brunofbloq/testrepo/mallow_adapt_v1.3.kicad_pcb

## KiCad design mallow_adapt_v1.3.kicad_pcb (2025-02-27)

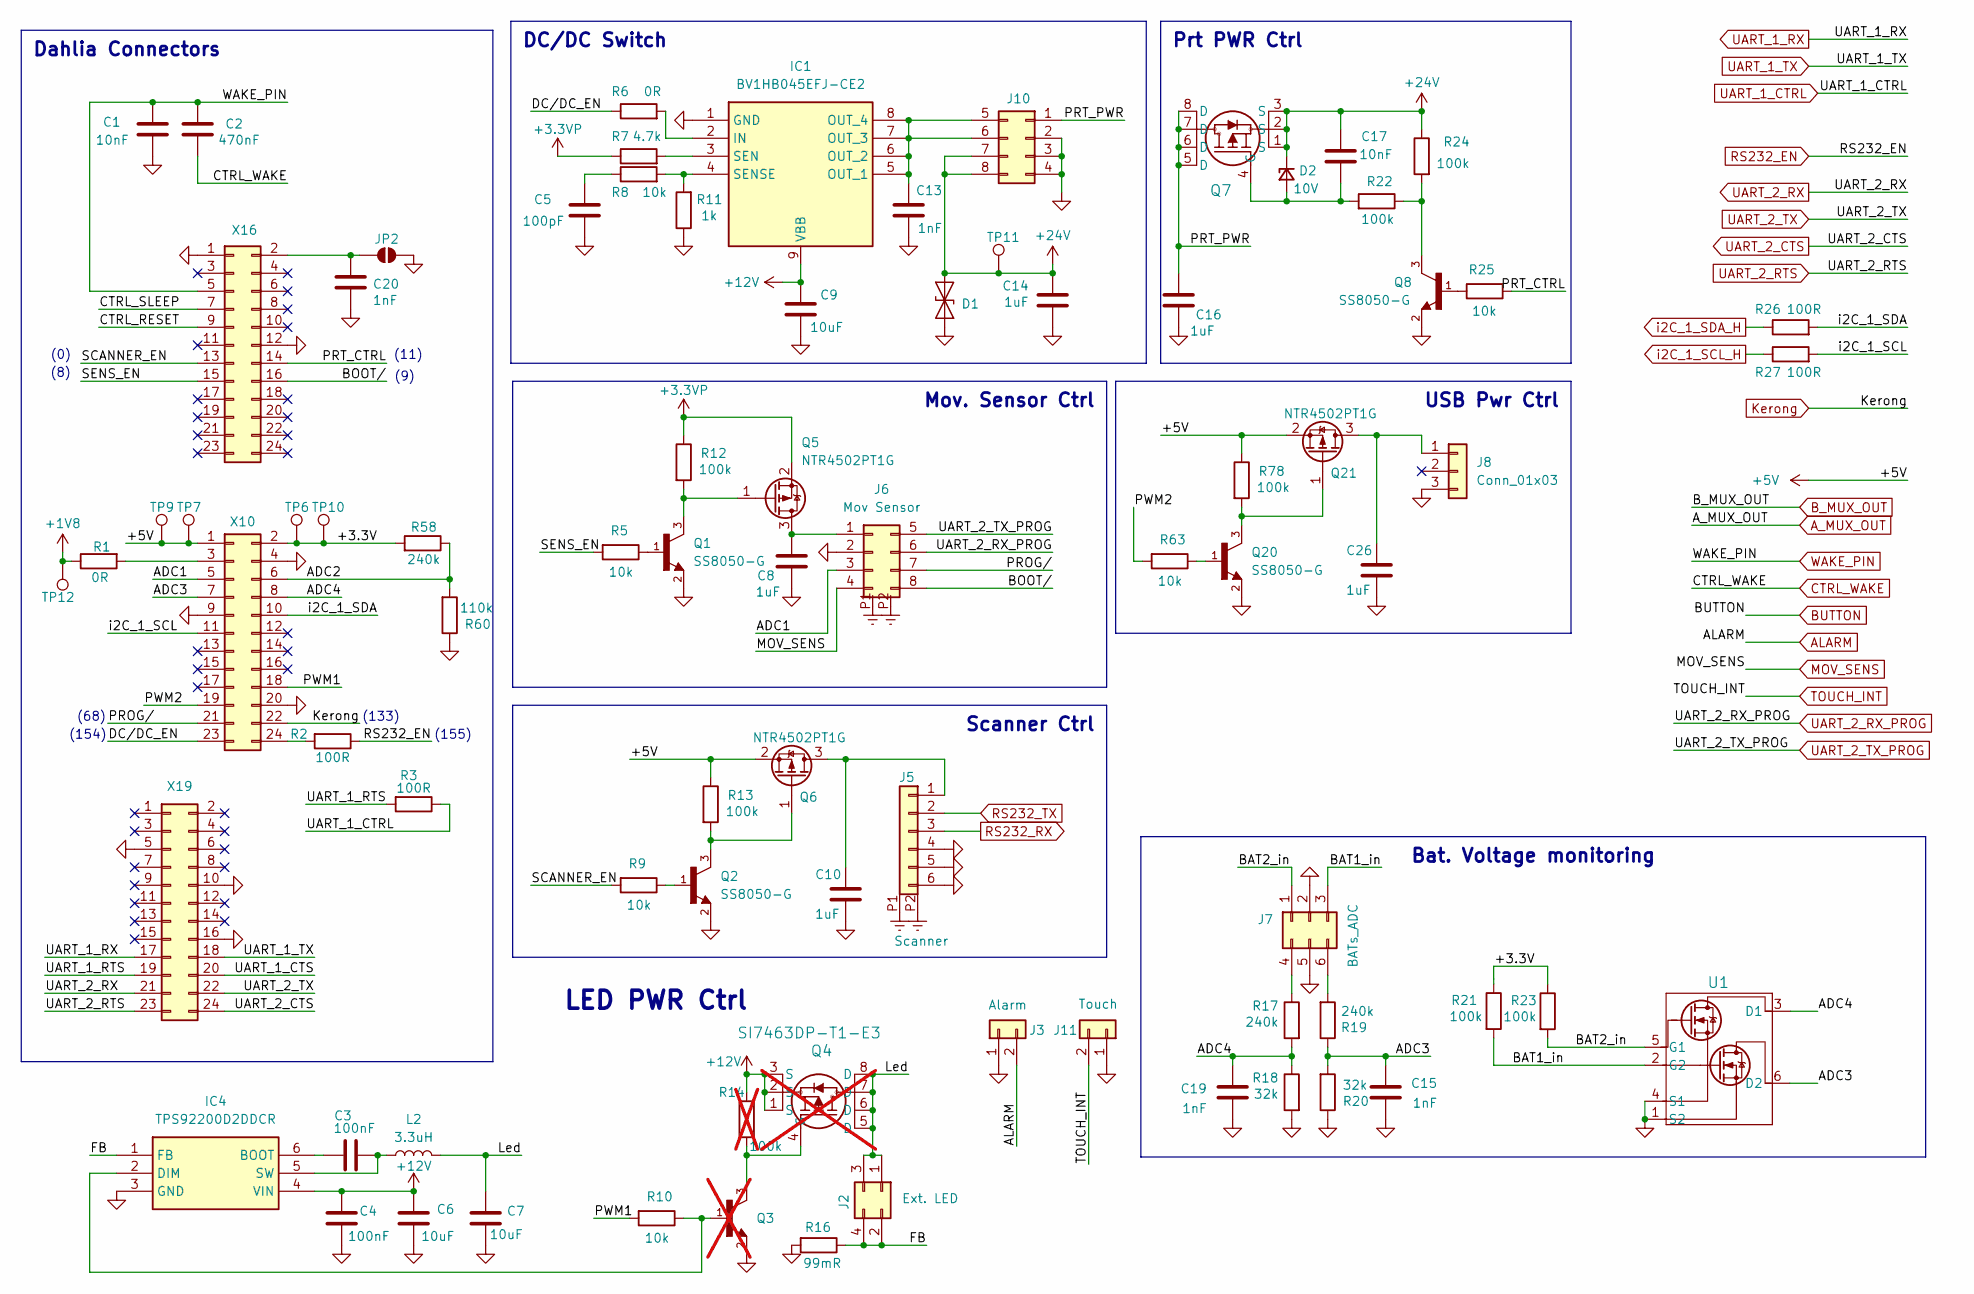
[picture p1: schematic connect.kicad_sch]

Parts:
C1, C17: 10nF; C_0603_1608Metric
C2: 470nF; C_0603_1608Metric
C3, C4: 100nF; C_0603_1608Metric
C5: 100pF; C_0603_1608Metric
C6, C7, C9: 10uF; C_0805_2012Metric
C8, C10, C16, C26: 1uF; C_0603_1608Metric
C13, C15, C19, C20: 1nF; C_0603_1608Metric
C14: 1uF; C_0805_2012Metric
D1: SMAJ24CA; D_SMA
D2: 10V; D_SOD-323_HandSoldering
IC1: BV1HB045EFJ-CE2; SOIC127P600X100-9N; Manufacturer_Part_Number BV1HB045EFJ-CE2
IC4: TPS92200D2DDCR; SOT95P280X110-6N; Manufacturer_Part_Number TPS92200D2DDCR
J2: Ext. LED; 1053101104
J3: Alarm; 1053091202
J5: Scanner; CON_430450624_MOL
J6: Mov Sensor; CON_1053121108
J7: BATs_ADC; CON_1053101106
J8: Conn_01x03; 1053091203
J10: 46015-0803
J11: Touch; Molex_PicoBlade_53048-0210_1x02_P1.25mm_Horizontal
JP2: Recovery; SolderJumper-2_P1.3mm_Open_RoundedPad1.0x1.5mm
L2: 3.3uH; L_1210_3225Metric
Q1, Q2, Q8, Q20: SS8050-G; TRANS_SS8050-G; PARTREV A
Q3: SS8050-G; TRANS_SS8050-G; PARTREV A; not fitted
Q4: SI7463DP-T1-E3; MOSFET_65DP-T1-E3_VIS; not fitted
Q5, Q6, Q21: NTR4502PT1G; SOT96P237X111-3N
Q7: SI7463DP-T1-E3; MOSFET_65DP-T1-E3_VIS
R1, R6: 0R; R_0603_1608Metric
R2, R3, R26, R27: 100R; R_0603_1608Metric
R5, R8, R9, R10, R25, R63: 10k; R_0603_1608Metric
R7: 4.7k; R_0603_1608Metric
R11: 1k; R_0603_1608Metric
R12, R13, R21, R22, R23, R24, R78: 100k; R_0603_1608Metric
R14: 100k; R_0603_1608Metric; not fitted
R16: 99mR; R_0805_2012Metric
R17, R19, R58: 240k; R_0603_1608Metric
R18, R20: 32k; R_0603_1608Metric
R60: 110k; R_0603_1608Metric
TP6, TP7, TP9, TP10, TP11, TP12: TestPoint; TestPoint_Pad_D2.0mm
U1: DMN53D0LDW-7; SOT-363_DIO
X10, X16, X19: Conn_02x12_Odd_Even; PinHeader_2x12_P2.54mm_Vertical

Connections:
+1V8: R1.1, TP12.1; also elsewhere on the board
+3.3VP: Q5.2 (S), R7.1, R12.1; also elsewhere on the board
+5V: Q6.2 (S), Q21.2 (S), R13.1, R78.1, TP7.1, TP9.1, X10.1
+12V: C4.1, C6.1, C9.1, IC1.9 (VBB), IC4.4 (VIN), Q4.1 (S), Q4.2 (S), Q4.3 (S), R14.1; also elsewhere on the board
+24V: C14.1, C17.1, D1.2 (A2), D2.1 (K), J10.7, J10.8, Q7.1 (S), Q7.2 (S), Q7.3 (S), R24.1, TP11.1; also elsewhere on the board
/Connectors/+3.3V: R21.1, R23.1, R58.2, TP6.1, TP10.1, X10.2
/Connectors/ADC1: J6.3, X10.5
/Connectors/ADC2: R58.1, R60.2, X10.6
/Connectors/ADC3: C15.1, R19.1, R20.2, U1.6 (D2), X10.7
/Connectors/ADC4: C19.1, R17.2, R18.1, U1.3 (D1), X10.8
/Connectors/BAT1_in: J7.3, R21.2, U1.2 (G2)
/Connectors/BAT2_in: J7.1, R23.2, U1.5 (G1)
/Connectors/BOOT/: J6.8, X16.16
/Connectors/CTRL_RESET: X16.9
/Connectors/CTRL_SLEEP: X16.7
/Connectors/DC/DC_EN: R6.1, X10.23
/Connectors/FB: IC4.1 (FB), J2.2, J2.4, R16.1
/Connectors/Led: C7.1, J2.1, J2.3, L2.2, Q4.5 (D), Q4.6 (D), Q4.7 (D), Q4.8 (D)
/Connectors/PROG/: J6.7, X10.21
/Connectors/PRT_CTRL: R25.2, X16.14
/Connectors/PRT_PWR: C16.1, J10.1, Q7.5 (D), Q7.6 (D), Q7.7 (D), Q7.8 (D)
/Connectors/PWM1: R10.2, X10.18
/Connectors/PWM2: R63.2, X10.19
/Connectors/SCANNER_EN: R9.2, X16.13
/Connectors/SENS_EN: R5.2, X16.15
/Connectors/UART_1_CTS: X19.20
/Connectors/UART_1_RTS: R3.2, X19.19
/Connectors/i2C_1_SCL: R27.2, X10.11
/Connectors/i2C_1_SDA: R26.2, X10.10
ALARM: J3.2; also elsewhere on the board
CTRL_WAKE: C2.2; also elsewhere on the board
GND: C1.2, C4.2, C5.2, C6.2, C7.2, C8.2, C9.2, C10.2, C13.2, C14.2, C15.2, C16.2, C19.2, C20.2, C26.2, D1.1 (A1), IC1.1 (GND), IC4.3 (GND), J3.1, J5.4, J5.5, J5.6, J6.2, J7.2, J7.5, J8.3, J10.2, J10.3, J10.4, J11.1, JP2.2 (B), Q1.2, Q2.2, Q3.2, Q8.2, Q20.2, R11.1, R16.2, R18.2, R20.1, R60.1, U1.1 (S2), U1.4 (S1), X10.4, X10.9, X10.20, X16.1, X16.12, X19.5, X19.10, X19.16; also elsewhere on the board
GND_CHASSIS: J5.P1 (Pin_6), J5.P2 (Pin_6), J6.P1 (Pin_8), J6.P2 (Pin_8); also elsewhere on the board
Kerong: X10.22; also elsewhere on the board
MOV_SENS: J6.4; also elsewhere on the board
unnamed: C5.1, R8.1
unnamed: C17.2, D2.2 (A), Q7.4 (G), R22.2
unnamed: IC1.2 (IN), R6.2
unnamed: C13.1, IC1.5 (OUT_1), IC1.6 (OUT_2), IC1.7 (OUT_3), IC1.8 (OUT_4), J10.5, J10.6
unnamed: IC1.3 (SEN), R7.2
unnamed: IC1.4 (SENSE), R8.2, R11.2
unnamed: C3.1, IC4.6 (BOOT)
unnamed: IC4.2 (DIM), Q3.1, R10.1
unnamed: C3.2, IC4.5 (SW), L2.1
unnamed: C10.1, J5.1, Q6.3 (D)
unnamed: C8.1, J6.1, Q5.3 (D)
unnamed: J7.4, R17.1
unnamed: J7.6, R19.2
unnamed: C26.1, J8.1, Q21.3 (D)
unnamed: C20.1, JP2.1 (A), X16.2
unnamed: Q1.1, R5.1
unnamed: Q2.1, R9.1
unnamed: Q3.3, Q4.4 (G), R14.2
unnamed: Q1.3, Q5.1 (G), R12.2
unnamed: Q2.3, Q6.1 (G), R13.2
unnamed: Q8.1, R25.1
unnamed: Q8.3, R22.1, R24.2
unnamed: Q20.1, R63.1
unnamed: Q20.3, Q21.1 (G), R78.2
unnamed: R1.2, X10.3
unnamed: R2.2, X10.24
RS232_EN: R2.1; also elsewhere on the board
RS232_RX: J5.3; also elsewhere on the board
RS232_TX: J5.2; also elsewhere on the board
TOUCH_INT: J11.2; also elsewhere on the board
UART_1_CTRL: R3.1; also elsewhere on the board
UART_1_RX: X19.17; also elsewhere on the board
UART_1_TX: X19.18; also elsewhere on the board
UART_2_CTS: X19.24; also elsewhere on the board
UART_2_RTS: X19.23; also elsewhere on the board
UART_2_RX: X19.21; also elsewhere on the board
UART_2_RX_PROG: J6.6; also elsewhere on the board
UART_2_TX: X19.22; also elsewhere on the board
UART_2_TX_PROG: J6.5; also elsewhere on the board
WAKE_PIN: C1.1, C2.1, X16.5; also elsewhere on the board
i2C_1_SCL_H: R27.1; also elsewhere on the board
i2C_1_SDA_H: R26.1; also elsewhere on the board

Notes on the sheet:
USB Pwr Ctrl
Dahlia Connectors
LED PWR Ctrl
Bat. Voltage monitoring
Scanner Ctrl
DC/DC Switch
Mov. Sensor Ctrl
Prt PWR Ctrl
(0)
(8)
(9)
(133)
(68)
(154)
(11)
(155)

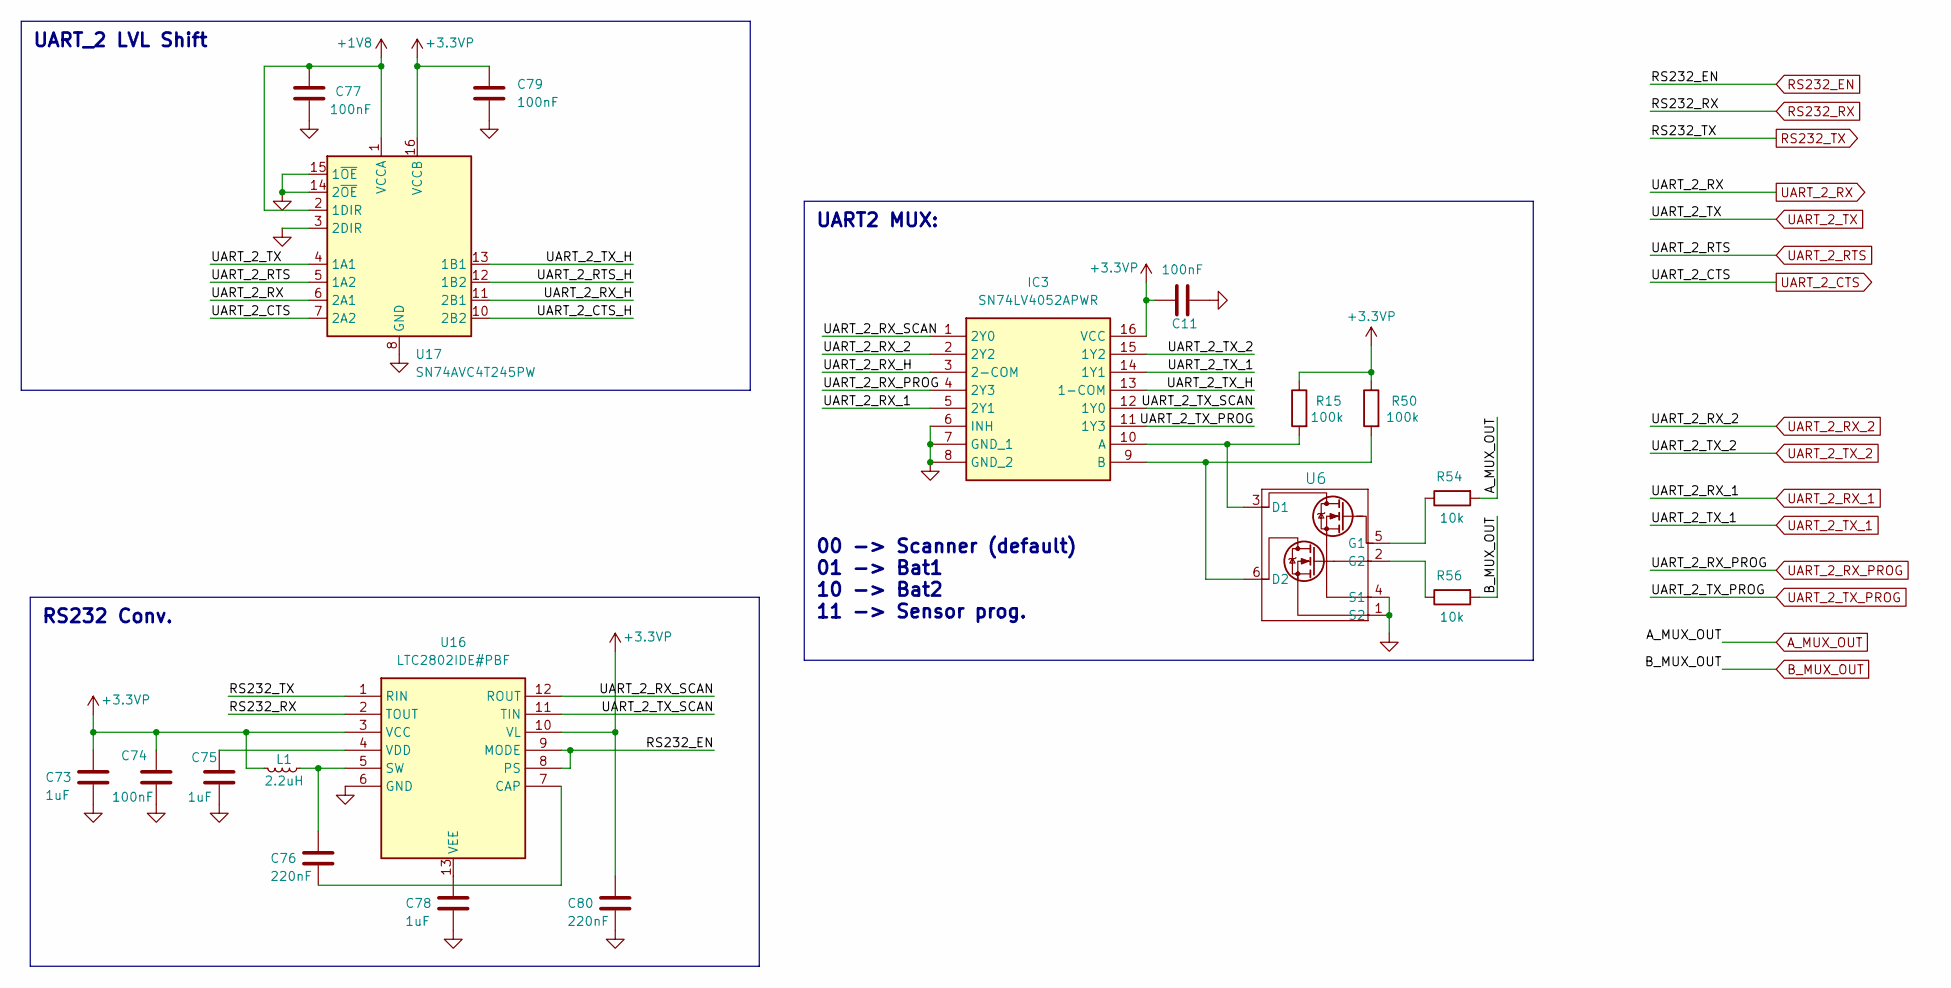
[picture p2: schematic untitled.kicad_sch]

Parts:
C11, C74, C77, C79: 100nF; C_0603_1608Metric
C73, C75, C78: 1uF; C_0603_1608Metric
C76, C80: 220nF; C_0603_1608Metric
IC3: SN74LV4052APWR; SOP65P640X120-16N; Manufacturer_Part_Number SN74LV4052APWR; Mouser Part Number 595-SN74LV4052APWR
L1: 2.2uH; L_0805_2012Metric
R15, R50: 100k; R_0603_1608Metric
R54, R56: 10k; R_0603_1608Metric
U6: DMN53D0LDW-7; SOT-363_DIO
U16: LTC2802IDE#PBF; LTC2802__SON50P300X400X80-13N-D; Manufacturer_Part_Number LTC2802IDE#PBF; Mouser Part Number 584-LTC2802IDE#PBF
U17: SN74AVC4T245PW; TSSOP-16_4.4x5mm_P0.65mm

Connections:
+1V8: C77.1, U17.1 (VCCA), U17.2 (1DIR); also elsewhere on the board
+3.3VP: C11.1, C73.1, C74.1, C79.1, C80.1, IC3.16 (VCC), L1.2, R15.1, R50.1, U16.3 (VCC), U16.10 (VL), U17.16 (VCCB); also elsewhere on the board
/UARTs/UART_2_CTS_H: U17.10 (2B2)
/UARTs/UART_2_RTS_H: U17.12 (1B2)
/UARTs/UART_2_RX_H: IC3.3 (2-COM), U17.11 (2B1)
/UARTs/UART_2_RX_SCAN: IC3.1 (2Y0), U16.12 (ROUT)
/UARTs/UART_2_TX_H: IC3.13 (1-COM), U17.13 (1B1)
/UARTs/UART_2_TX_SCAN: IC3.12 (1Y0), U16.11 (TIN)
A_MUX_OUT: R54.2; also elsewhere on the board
B_MUX_OUT: R56.2; also elsewhere on the board
GND: C11.2, C73.2, C74.2, C75.2, C77.2, C78.2, C79.2, C80.2, IC3.6 (INH), IC3.7 (GND_1), IC3.8 (GND_2), U6.1 (S2), U6.4 (S1), U16.6 (GND), U17.3 (2DIR), U17.8 (GND), U17.9 (GND), U17.14 (2~OE), U17.15 (1~OE); also elsewhere on the board
unnamed: IC3.10 (A), R15.2, U6.3 (D1)
unnamed: IC3.9 (B), R50.2, U6.6 (D2)
unnamed: R54.1, U6.5 (G1)
unnamed: R56.1, U6.2 (G2)
unnamed: C76.2, U16.7 (CAP)
unnamed: C76.1, L1.1, U16.5 (SW)
unnamed: C75.1, U16.4 (VDD)
unnamed: C78.1, U16.13 (VEE)
RS232_EN: U16.8 (PS), U16.9 (MODE); also elsewhere on the board
RS232_RX: U16.2 (TOUT); also elsewhere on the board
RS232_TX: U16.1 (RIN); also elsewhere on the board
UART_2_CTS: U17.7 (2A2); also elsewhere on the board
UART_2_RTS: U17.5 (1A2); also elsewhere on the board
UART_2_RX: U17.6 (2A1); also elsewhere on the board
UART_2_RX_1: IC3.5 (2Y1); also elsewhere on the board
UART_2_RX_2: IC3.2 (2Y2); also elsewhere on the board
UART_2_RX_PROG: IC3.4 (2Y3); also elsewhere on the board
UART_2_TX: U17.4 (1A1); also elsewhere on the board
UART_2_TX_1: IC3.14 (1Y1); also elsewhere on the board
UART_2_TX_2: IC3.15 (1Y2); also elsewhere on the board
UART_2_TX_PROG: IC3.11 (1Y3); also elsewhere on the board

Notes on the sheet:
UART_2 LVL Shift
RS232 Conv.
UART2 MUX: 00 -> Scanner (default) 01 -> Bat1 10 -> Bat2 11 -> Sensor prog.

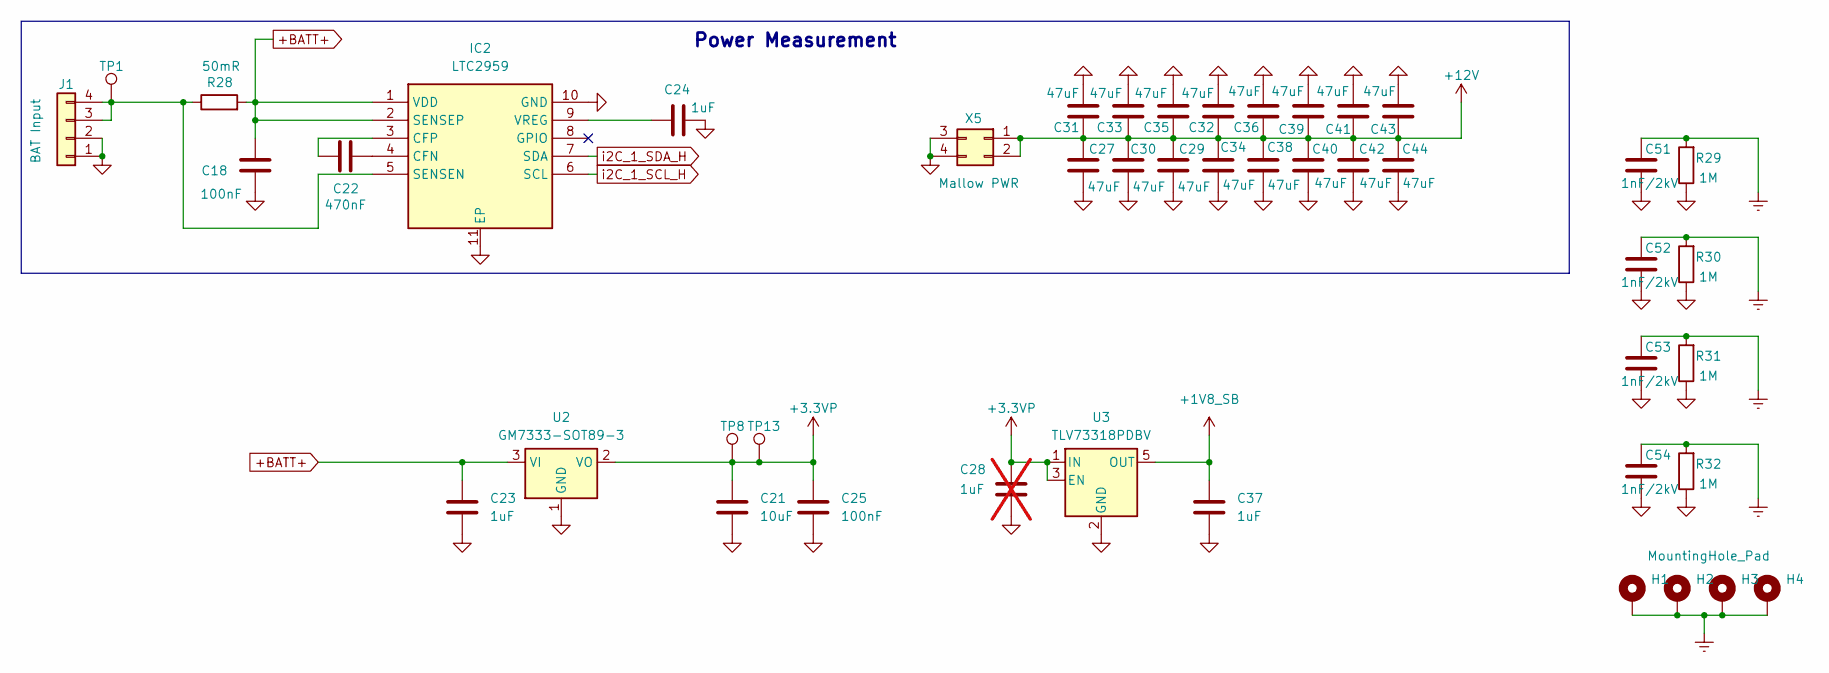
[picture p3: schematic PSU.kicad_sch]

Parts:
C18, C25: 100nF; C_0603_1608Metric
C21: 10uF; C_0603_1608Metric
C22: 470nF; C_0603_1608Metric
C23, C24, C37: 1uF; C_0603_1608Metric
C27, C29, C30, C31, C32, C33, C34, C35, C36, C38, C39, C40, C41, C42, C43, C44: 47uF; C_1210_3225Metric
C28: 1uF; C_0603_1608Metric; not fitted
C51, C52, C53, C54: 1nF/2kV; C_1206_3216Metric
H1, H2, H3, H4: MountingHole_Pad; MountingHole_3.2mm_M3_ISO7380_Pad_TopBottom
IC2: LTC2959; SON50P200X300X80-11N-D; Manufacturer_Part_Number LTC2959; Mouser Part Number N/A
J1: BAT Input; 46015-0403
R28: 50mR; R_2512_6332Metric
R29, R30, R31, R32: 1M; R_1206_3216Metric
TP1, TP8, TP13: TestPoint; TestPoint_Pad_D2.0mm
U2: GM7333-SOT89-3; SOT-89-3
U3: TLV73318PDBV; SOT-23-5
X5: Mallow PWR; PinHeader_2x02_P2.54mm_Vertical

Connections:
+1V8_SB: C37.1, U3.5 (OUT); also elsewhere on the board
+3.3VP: C21.1, C25.1, C28.1, TP8.1, TP13.1, U2.2 (VO), U3.1 (IN), U3.3 (EN); also elsewhere on the board
+12V: C27.1, C29.1, C30.1, C31.1, C32.1, C33.1, C34.1, C35.1, C36.1, C38.1, C39.1, C40.1, C41.1, C42.1, C43.1, C44.1, X5.1, X5.2; also elsewhere on the board
+BATT+: C18.1, C23.1, IC2.1 (VDD), IC2.2 (SENSEP), R28.2, U2.3 (VI); also elsewhere on the board
GND: C18.2, C21.2, C23.2, C24.2, C25.2, C27.2, C28.2, C29.2, C30.2, C31.2, C32.2, C33.2, C34.2, C35.2, C36.2, C37.2, C38.2, C39.2, C40.2, C41.2, C42.2, C43.2, C44.2, C51.2, C52.2, C53.2, C54.2, IC2.10 (GND), IC2.11 (EP), J1.1, J1.2, R29.1, R30.1, R31.1, R32.1, U2.1 (GND), U3.2 (GND), X5.3, X5.4; also elsewhere on the board
GND_CHASSIS: C51.1, C52.1, C53.1, C54.1, H1.1, H2.1, H3.1, H4.1, R29.2, R30.2, R31.2, R32.2; also elsewhere on the board
unnamed: C22.2, IC2.4 (CFN)
unnamed: C22.1, IC2.3 (CFP)
unnamed: IC2.5 (SENSEN), J1.3, J1.4, R28.1, TP1.1
unnamed: C24.1, IC2.9 (VREG)
i2C_1_SCL_H: IC2.6 (SCL); also elsewhere on the board
i2C_1_SDA_H: IC2.7 (SDA); also elsewhere on the board

Notes on the sheet:
Power Measurement

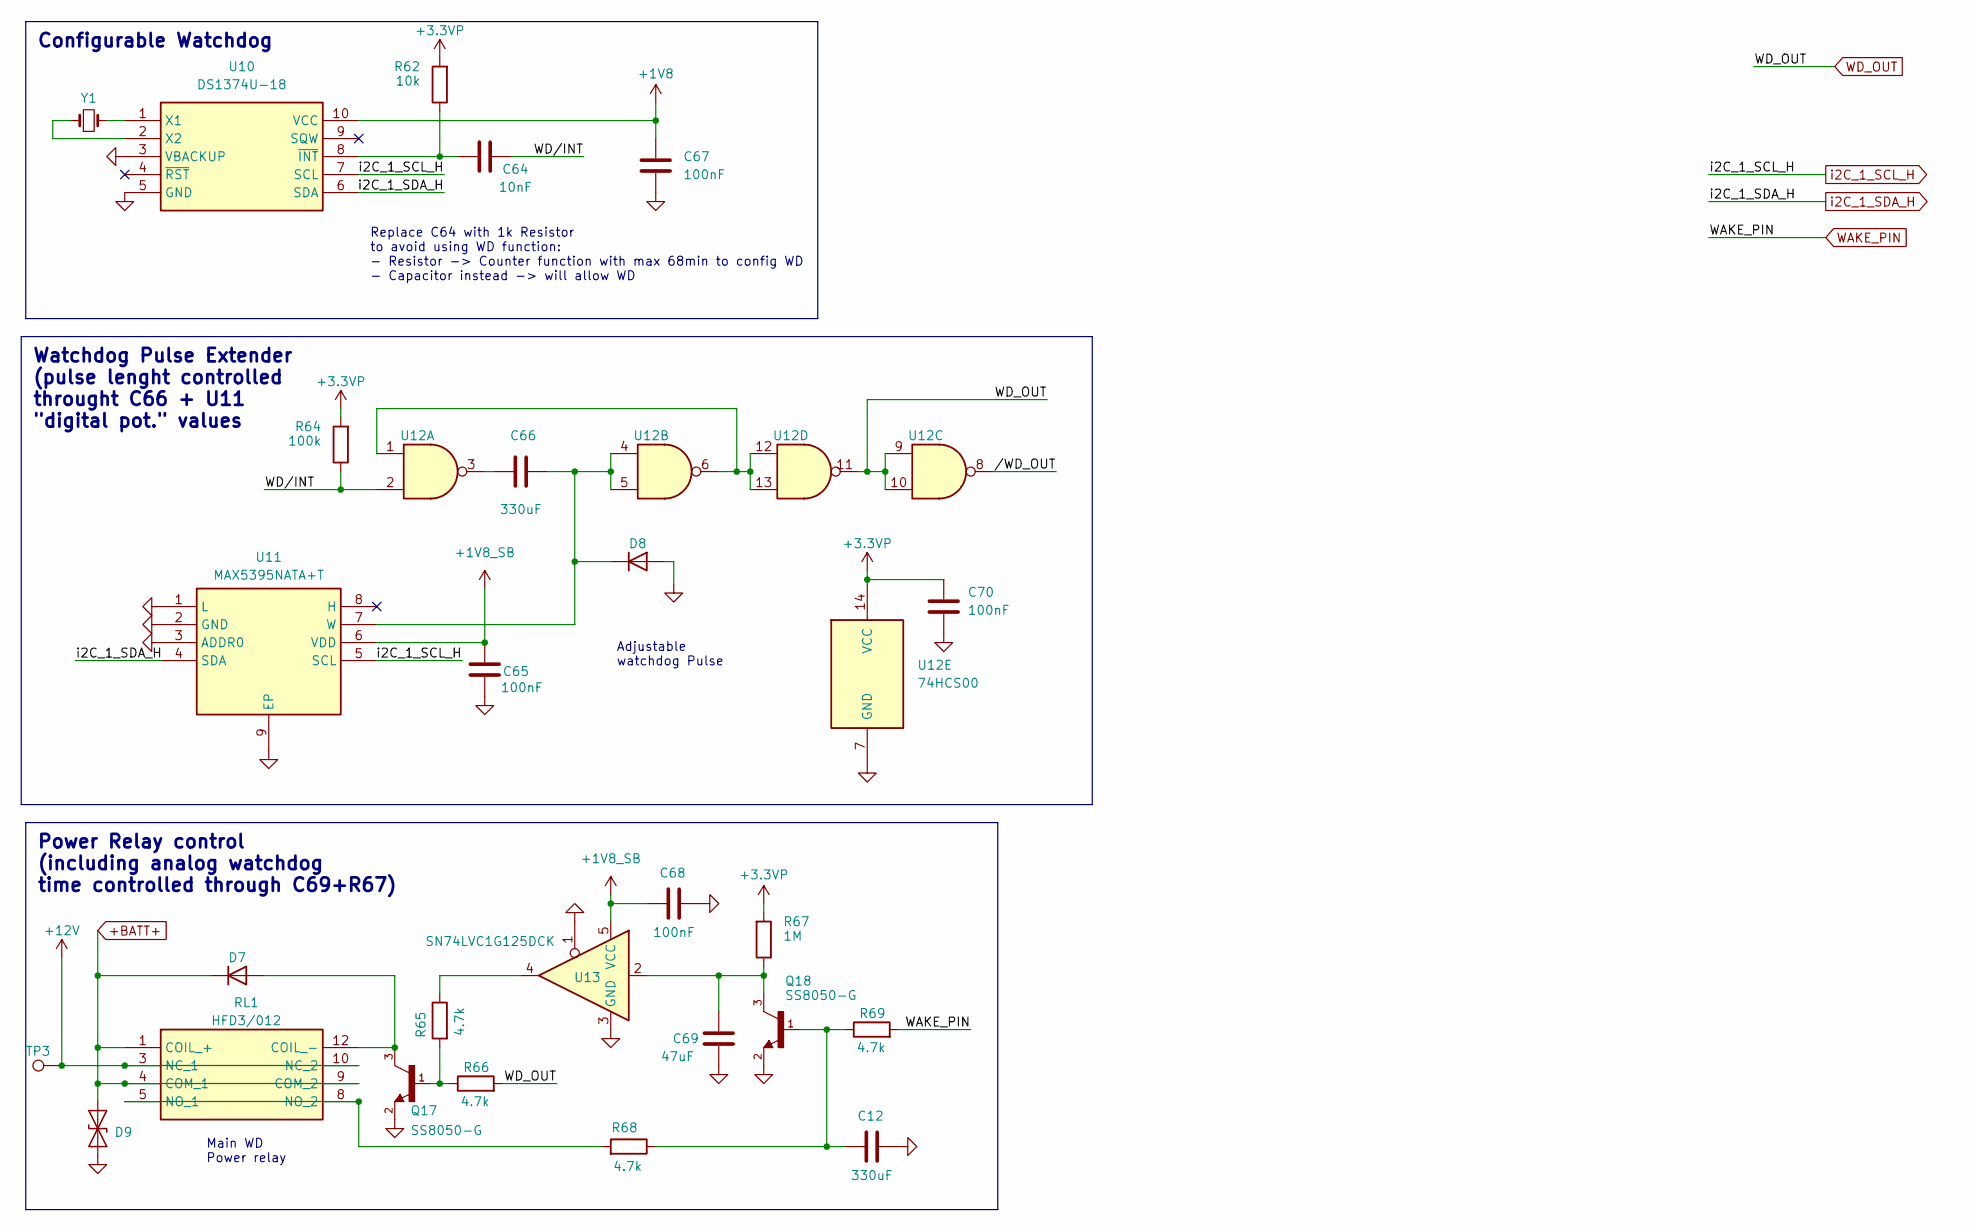
[picture p4: schematic WatchDog.kicad_sch]

Parts:
C12, C66: 330uF; C_1210_3225Metric
C64: 10nF; C_0603_1608Metric
C65, C67, C68, C70: 100nF; C_0603_1608Metric
C69: 47uF; C_0603_1608Metric
D7, D8: 1n4148W; D_SOD-123
D9: SMAJ14CA; D_SMA
Q17, Q18: SS8050-G; TRANS_SS8050-G; PARTREV A
R62: 10k; R_0603_1608Metric
R64: 100k; R_0603_1608Metric
R65, R66, R68, R69: 4.7k; R_0603_1608Metric
R67: 1M; R_0603_1608Metric
RL1: HFD3/012; TX2SA12V; Manufacturer_Part_Number TX2SA-12V; Mouser Part Number 769-TX2SA-12V
TP3: TestPoint; TestPoint_Pad_D2.0mm
U10: DS1374U-18; SOP50P490X110-10N; Manufacturer_Part_Number DS1374U-3+; Mouser Part Number 700-DS1374U-3
U11: MAX5395NATA+T; MAX5393__SON50P200X200X80-9N-D; Manufacturer_Part_Number MAX5395NATA+T; Mouser Part Number 700-MAX5395NATA+T
U12: 74HCS00; TSSOP-14_4.4x5mm_P0.65mm
U13: SN74LVC1G125DCK; Texas_R-PDSO-G5_DCK-5
Y1: Crystal_Small; Crystal_SMD_3215-2Pin_3.2x1.5mm

Connections:
+1V8: C67.1, U10.10 (VCC); also elsewhere on the board
+1V8_SB: C65.1, C68.1, U11.6 (VDD), U13.5 (VCC); also elsewhere on the board
+3.3VP: C70.1, R62.2, R64.2, R67.2, U12.14 (VCC); also elsewhere on the board
+12V: RL1.3 (NC_1), RL1.10 (NC_2), TP3.1; also elsewhere on the board
+BATT+: D7.1 (K), D9.2 (A2), RL1.1 (COIL_+), RL1.4 (COM_1), RL1.9 (COM_2); also elsewhere on the board
/Watchdog/WD/INT: C64.2, R64.1, U12.2
/Watchdog//WD_OUT: U12.8
GND: C12.2, C65.2, C67.2, C68.2, C69.2, C70.2, D8.2 (A), D9.1 (A1), Q17.2, Q18.2, U10.3 (VBACKUP), U10.5 (GND), U11.1 (L), U11.2 (GND), U11.3 (ADDR0), U11.9 (EP), U12.7 (GND), U13.1, U13.3 (GND); also elsewhere on the board
unnamed: C12.1, Q18.1, R68.1, R69.1
unnamed: C66.1, U12.3
unnamed: C69.1, Q18.3, R67.1, U13.2
unnamed: D7.2 (A), Q17.3, RL1.12 (COIL_-)
unnamed: C66.2, D8.1 (K), U11.7 (W), U12.4, U12.5
unnamed: Q17.1, R65.2, R66.1
unnamed: R65.1, U13.4
unnamed: R68.2, RL1.5 (NO_1), RL1.8 (NO_2)
unnamed: U10.1 (X1), Y1.2
unnamed: U10.2 (X2), Y1.1
unnamed: C64.1, R62.1, U10.8 (~INT)
unnamed: U12.1, U12.6, U12.12, U12.13
WAKE_PIN: R69.2; also elsewhere on the board
WD_OUT: R66.2, U12.9, U12.10, U12.11
i2C_1_SCL_H: U10.7 (SCL), U11.5 (SCL); also elsewhere on the board
i2C_1_SDA_H: U10.6 (SDA), U11.4 (SDA); also elsewhere on the board

Notes on the sheet:
Watchdog Pulse Extender (pulse lenght controlled throught C66 + U11 "digital pot." values
Power Relay control (including analog watchdog time controlled through C69+R67)
Configurable Watchdog
Main WD Power relay
Adjustable watchdog Pulse
Replace C64 with 1k Resistor to avoid using WD function: - Resistor -> Counter function with max 68min to config WD - Capacitor instead -> will allow WD

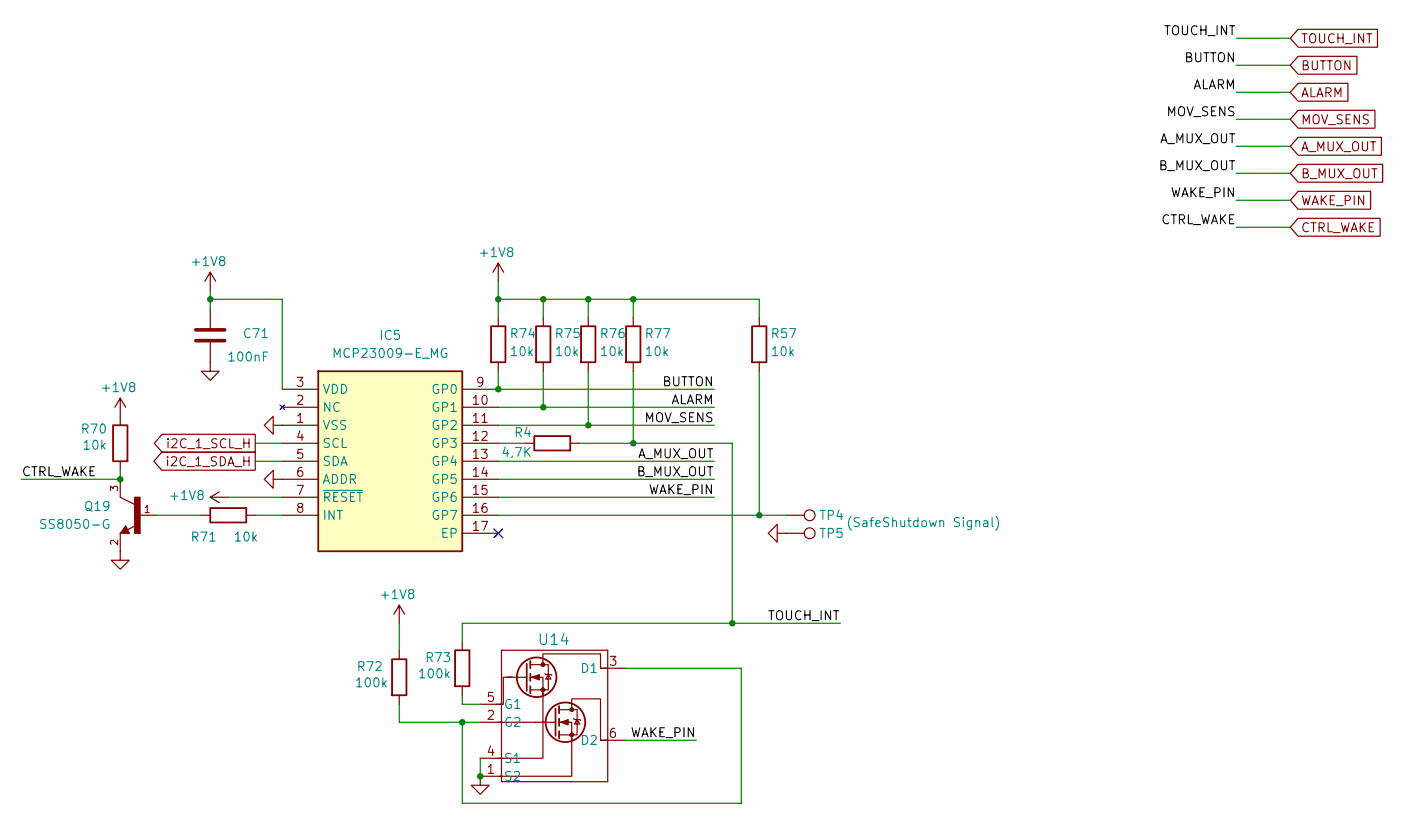
[picture p5: schematic Gpio_exp.kicad_sch]

Parts:
C71: 100nF; C_0603_1608Metric
IC5: MCP23009-E_MG; QFN50P300X300X90-17N-D; Manufacturer_Part_Number MCP23009-E/MG; Mouser Part Number 579-MCP23009-E/MG
Q19: SS8050-G; TRANS_SS8050-G; PARTREV A
R4: 4,7K; R_0603_1608Metric
R57, R70, R71, R74, R75, R76, R77: 10k; R_0603_1608Metric
R72, R73: 100k; R_0603_1608Metric
TP4: (SafeShutdown Signal); TestPoint_Pad_D2.0mm
TP5: TestPoint; TestPoint_Pad_D2.0mm
U14: DMN53D0LDW-7; SOT-363_DIO

Connections:
+1V8: C71.1, IC5.3 (VDD), IC5.7 (~RESET), R57.1, R70.1, R72.1, R74.1, R75.1, R76.1, R77.1; also elsewhere on the board
ALARM: IC5.10 (GP1), R75.2; also elsewhere on the board
A_MUX_OUT: IC5.13 (GP4); also elsewhere on the board
BUTTON: IC5.9 (GP0), R74.2
B_MUX_OUT: IC5.14 (GP5); also elsewhere on the board
CTRL_WAKE: Q19.3, R70.2; also elsewhere on the board
GND: C71.2, IC5.1 (VSS), IC5.6 (ADDR), Q19.2, TP5.1, U14.1 (S2), U14.4 (S1); also elsewhere on the board
MOV_SENS: IC5.11 (GP2), R76.2; also elsewhere on the board
unnamed: IC5.12 (GP3), R4.1
unnamed: IC5.16 (GP7), R57.2, TP4.1
unnamed: IC5.8 (INT), R71.2
unnamed: Q19.1, R71.1
unnamed: R72.2, U14.2 (G2), U14.3 (D1)
unnamed: R73.2, U14.5 (G1)
TOUCH_INT: R4.2, R73.1, R77.2; also elsewhere on the board
WAKE_PIN: IC5.15 (GP6), U14.6 (D2); also elsewhere on the board
i2C_1_SCL_H: IC5.4 (SCL); also elsewhere on the board
i2C_1_SDA_H: IC5.5 (SDA); also elsewhere on the board

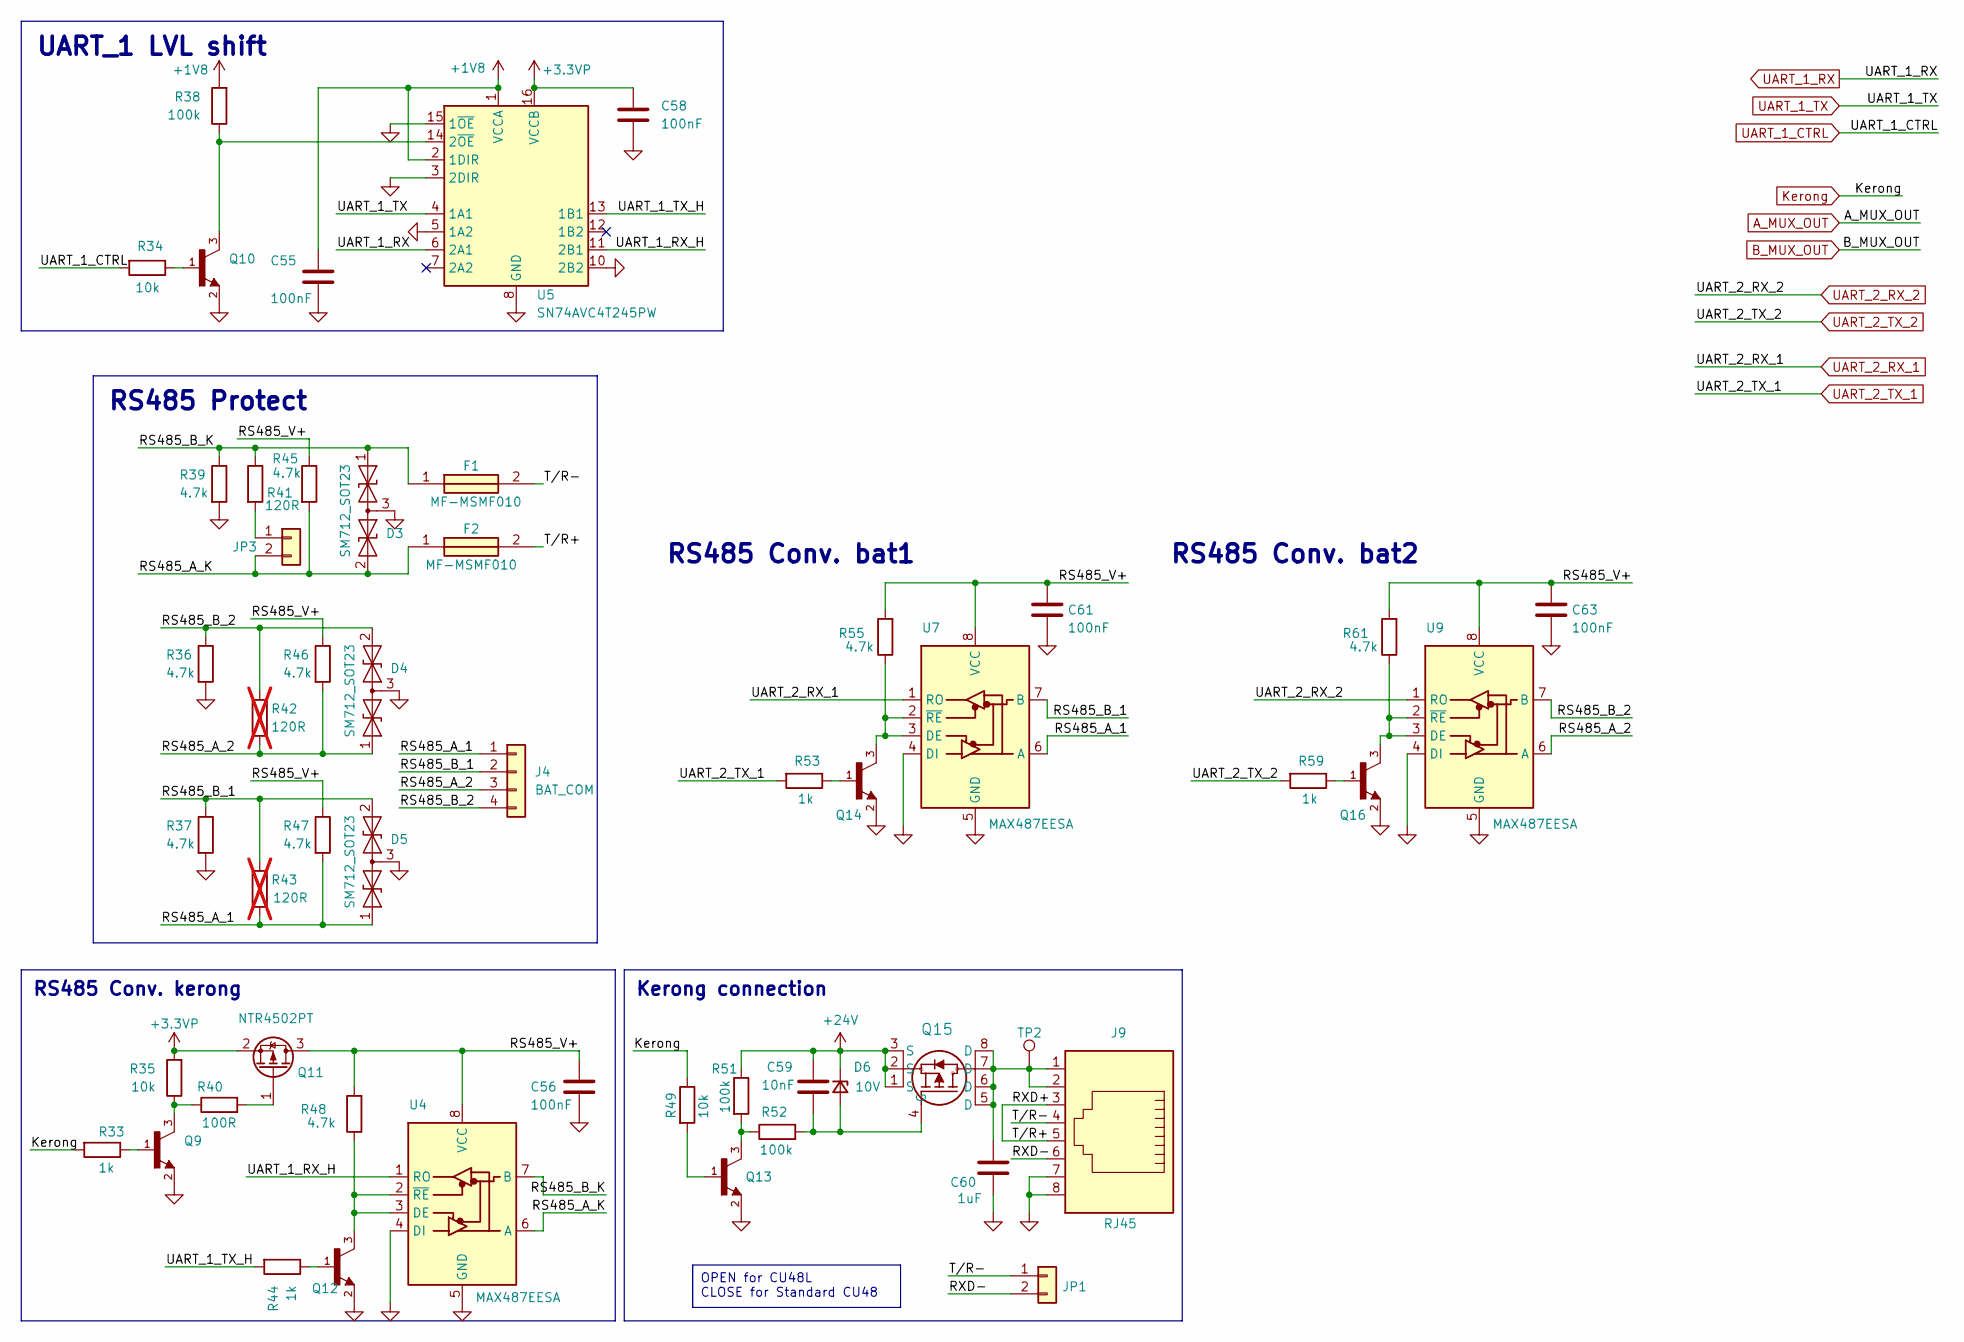
[picture p6: schematic RS485.kicad_sch, Mallow Adapter]

Parts:
C55, C56, C58, C61, C63: 100nF; C_0603_1608Metric
C59: 10nF; C_0603_1608Metric
C60: 1uF; C_0603_1608Metric
D3, D4, D5: SM712_SOT23; SOT-23
D6: 10V; D_SOD-323_HandSoldering
F1, F2: MF-MSMF010; FUSC4632X110N; Manufacturer_Part_Number MF-MSMF010
J4: BAT_COM; 1053091104
J9: RJ45; RJ45_OST_PJ012-8P8CX_Vertical
JP1, JP3: Conn_01x02; PinHeader_1x02_P2.54mm_Vertical
Q9, Q10, Q12, Q13, Q14, Q16: SS8050-G; TRANS_SS8050-G; PARTREV A
Q11: NTR4502PT; SOT96P237X111-3N
Q15: SI7463DP-T1-E3; MOSFET_65DP-T1-E3_VIS
R33, R44, R53, R59: 1k; R_0603_1608Metric
R34, R35, R49: 10k; R_0603_1608Metric
R36, R37, R39, R45, R46, R47, R48, R55, R61: 4.7k; R_0603_1608Metric
R38, R51, R52: 100k; R_0603_1608Metric
R40: 100R; R_0603_1608Metric
R41: 120R; R_0603_1608Metric
R42, R43: 120R; R_0603_1608Metric; not fitted
TP2: TestPoint; TestPoint_Pad_D2.0mm
U4, U7, U9: MAX487EESA; SOIC-8_3.9x4.9mm_P1.27mm
U5: SN74AVC4T245PW; TSSOP-16_4.4x5mm_P0.65mm

Connections:
+1V8: C55.1, R38.2, U5.1 (VCCA), U5.2 (1DIR); also elsewhere on the board
+3.3VP: C58.1, Q11.2 (S), R35.2, U5.16 (VCCB); also elsewhere on the board
+24V: C59.1, D6.1 (K), Q15.1 (S), Q15.2 (S), Q15.3 (S), R51.1; also elsewhere on the board
/Rs485/RS485_A_1: D5.1 (A1), J4.1, R43.2, R47.2, U7.6 (A)
/Rs485/RS485_A_2: D4.1 (A1), J4.3, R42.2, R46.2, U9.6 (A)
/Rs485/RS485_A_K: D3.2 (A2), F2.1, JP3.2, R45.2, U4.6 (A)
/Rs485/RS485_B_1: D5.2 (A2), J4.2, R37.1, R43.1, U7.7 (B)
/Rs485/RS485_B_2: D4.2 (A2), J4.4, R36.1, R42.1, U9.7 (B)
/Rs485/RS485_B_K: D3.1 (A1), F1.1, R39.1, R41.1, U4.7 (B)
/Rs485/RS485_V+: C56.1, C61.1, C63.1, Q11.3 (D), R45.1, R46.1, R47.1, R48.2, R55.2, R61.2, U4.8 (VCC), U7.8 (VCC), U9.8 (VCC)
/Rs485/RXD+: F2.2, J9.3, J9.5
/Rs485/RXD-: J9.6, JP1.2
/Rs485/T/R-: F1.2, J9.4, JP1.1
/Rs485/UART_1_RX_H: U4.1 (RO), U5.11 (2B1)
/Rs485/UART_1_TX_H: R44.2, U5.13 (1B1)
GND: C55.2, C56.2, C58.2, C60.2, C61.2, C63.2, D3.3 (common), D4.3 (common), D5.3 (common), J9.7, J9.8, Q9.2, Q10.2, Q12.2, Q13.2, Q14.2, Q16.2, R36.2, R37.2, R39.2, U4.4 (DI), U4.5 (GND), U5.3 (2DIR), U5.5 (1A2), U5.8 (GND), U5.9 (GND), U5.10 (2B2), U5.15 (1~OE), U7.4 (DI), U7.5 (GND), U9.4 (DI), U9.5 (GND); also elsewhere on the board
Kerong: R33.2, R49.1; also elsewhere on the board
unnamed: C60.1, J9.1, J9.2, Q15.5 (D), Q15.6 (D), Q15.7 (D), Q15.8 (D), TP2.1
unnamed: C59.2, D6.2 (A), Q15.4 (G), R52.2
unnamed: JP3.1, R41.2
unnamed: Q9.1, R33.1
unnamed: Q9.3, R35.1, R40.1
unnamed: Q10.1, R34.1
unnamed: Q11.1 (G), R40.2
unnamed: Q12.1, R44.1
unnamed: Q13.1, R49.2
unnamed: Q13.3, R51.2, R52.1
unnamed: Q14.1, R53.1
unnamed: Q16.1, R59.1
unnamed: Q12.3, R48.1, U4.2 (~RE), U4.3 (DE)
unnamed: Q10.3, R38.1, U5.14 (2~OE)
unnamed: Q14.3, R55.1, U7.2 (~RE), U7.3 (DE)
unnamed: Q16.3, R61.1, U9.2 (~RE), U9.3 (DE)
UART_1_CTRL: R34.2; also elsewhere on the board
UART_1_RX: U5.6 (2A1); also elsewhere on the board
UART_1_TX: U5.4 (1A1); also elsewhere on the board
UART_2_RX_1: U7.1 (RO); also elsewhere on the board
UART_2_RX_2: U9.1 (RO); also elsewhere on the board
UART_2_TX_1: R53.2; also elsewhere on the board
UART_2_TX_2: R59.2; also elsewhere on the board

Notes on the sheet:
UART_1 LVL shift
OPEN for CU48L CLOSE for Standard CU48
RS485 Conv. kerong
RS485 Conv. bat1
RS485 Protect
Kerong connection
RS485 Conv. bat2
