brunofbloq/testrepo/mallow_adapt_v1.3.kicad_pcb

## KiCad design mallow_adapt_v1.3.kicad_pcb (continued)

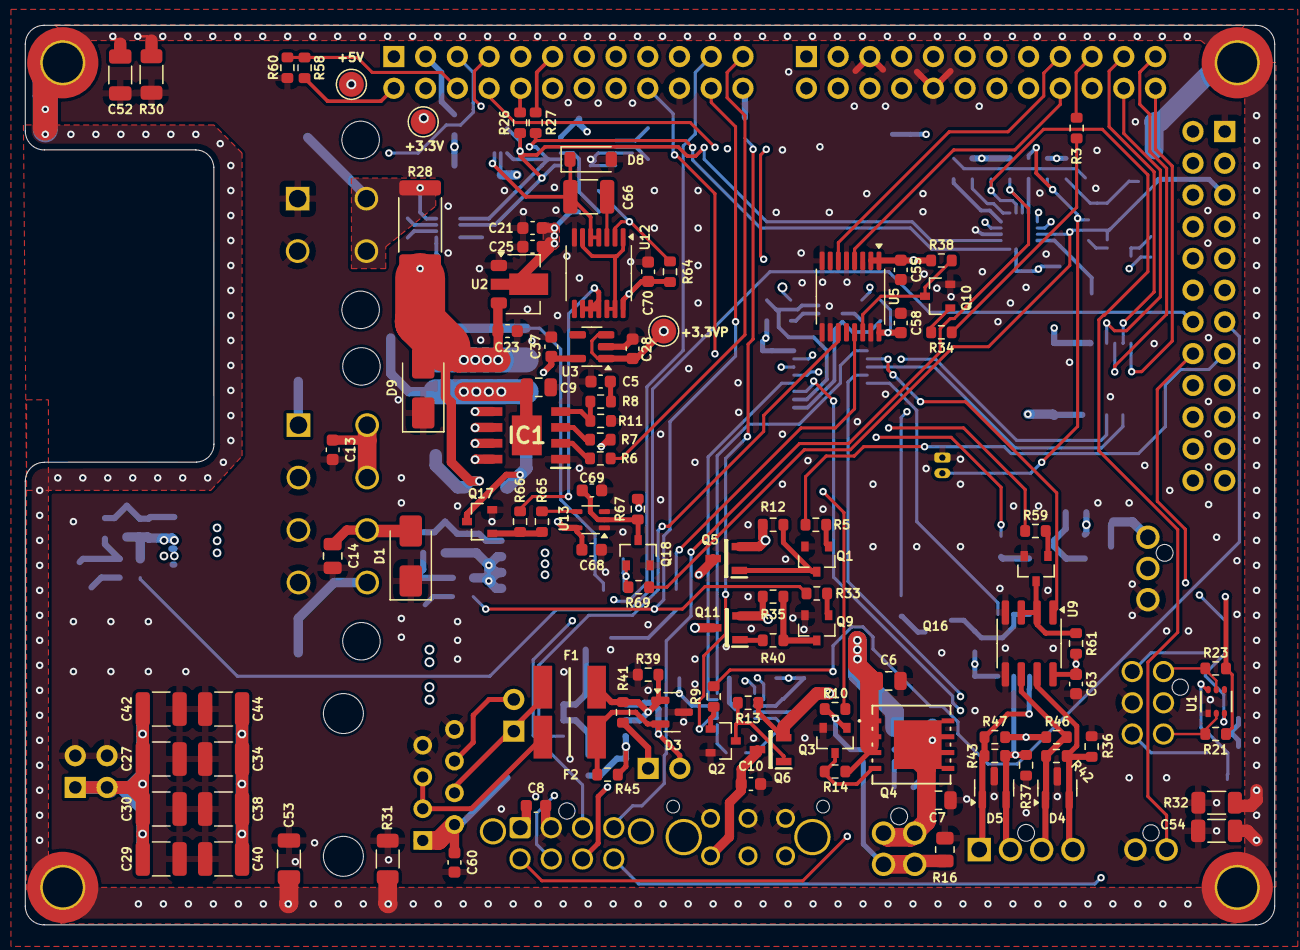
[picture p7: board mallow_adapt_v1.3.kicad_pcb from above]

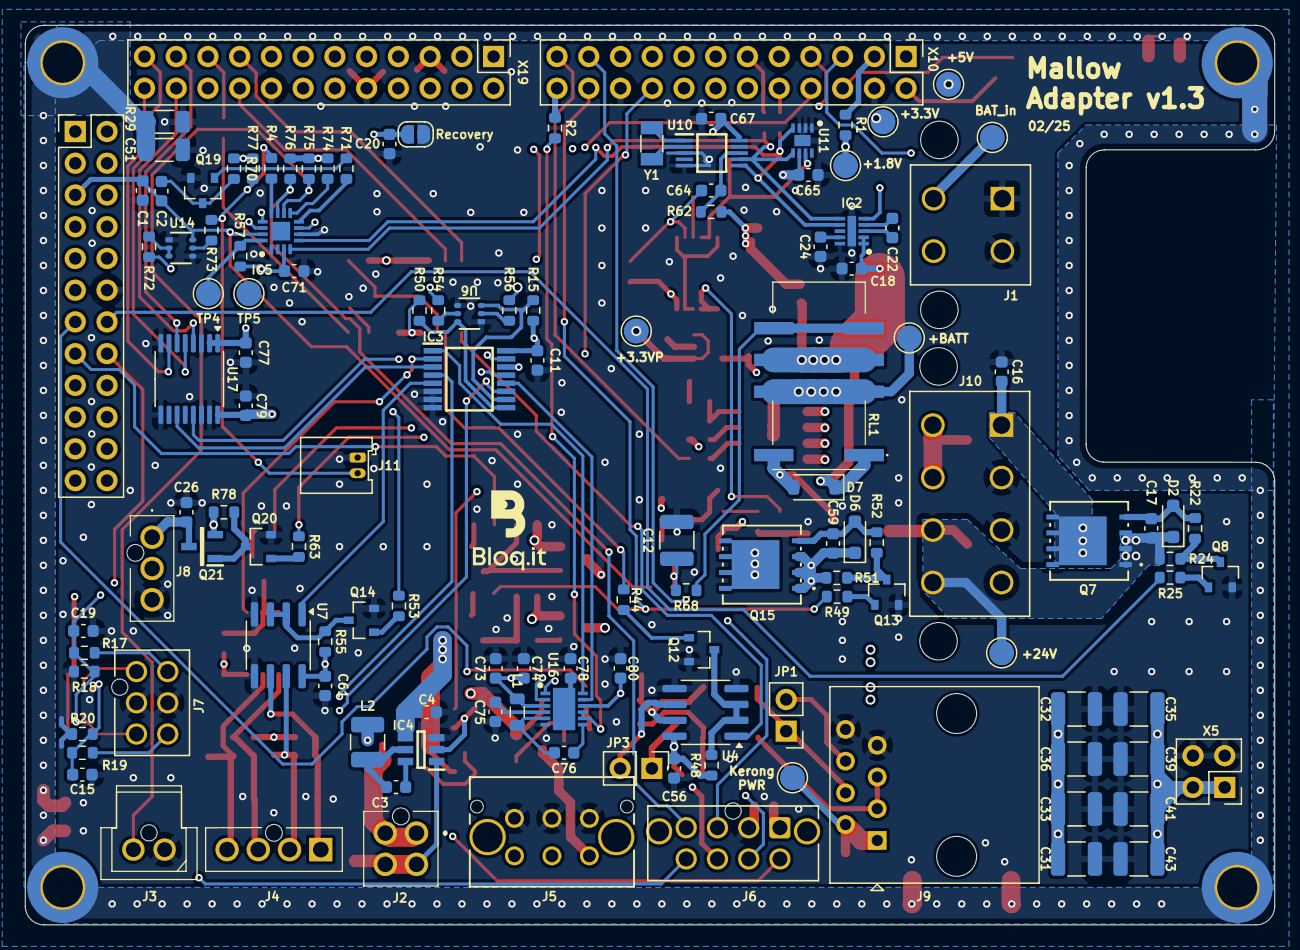
[picture p8: board mallow_adapt_v1.3.kicad_pcb from below]

Board: 4 copper layers, 100.0 x 72.0 mm, 240 parts (130 on the bottom side), 147 nets.
