brunofbloq/testrepo/(commit log)

2025-02-27 dasdre qwe
    [relays.kicad_sch]
2025-02-27 Update Gpio_exp.kicad_sch
    teasstea
    [Gpio_exp.kicad_sch]
